TriEverthing/SC8815_Portable_Power/README.md

# SC8815 Portable Power

升降压可调电源，输入电压支持2.7\~36V，输出电压0.8V\~36V可调，最大输出电流5A，支持PD和DC输入
