TriEverthing/SC8815_Portable_Power/Hardware/Schmeatic/SC8815_Portable_Power_1v0.pdf

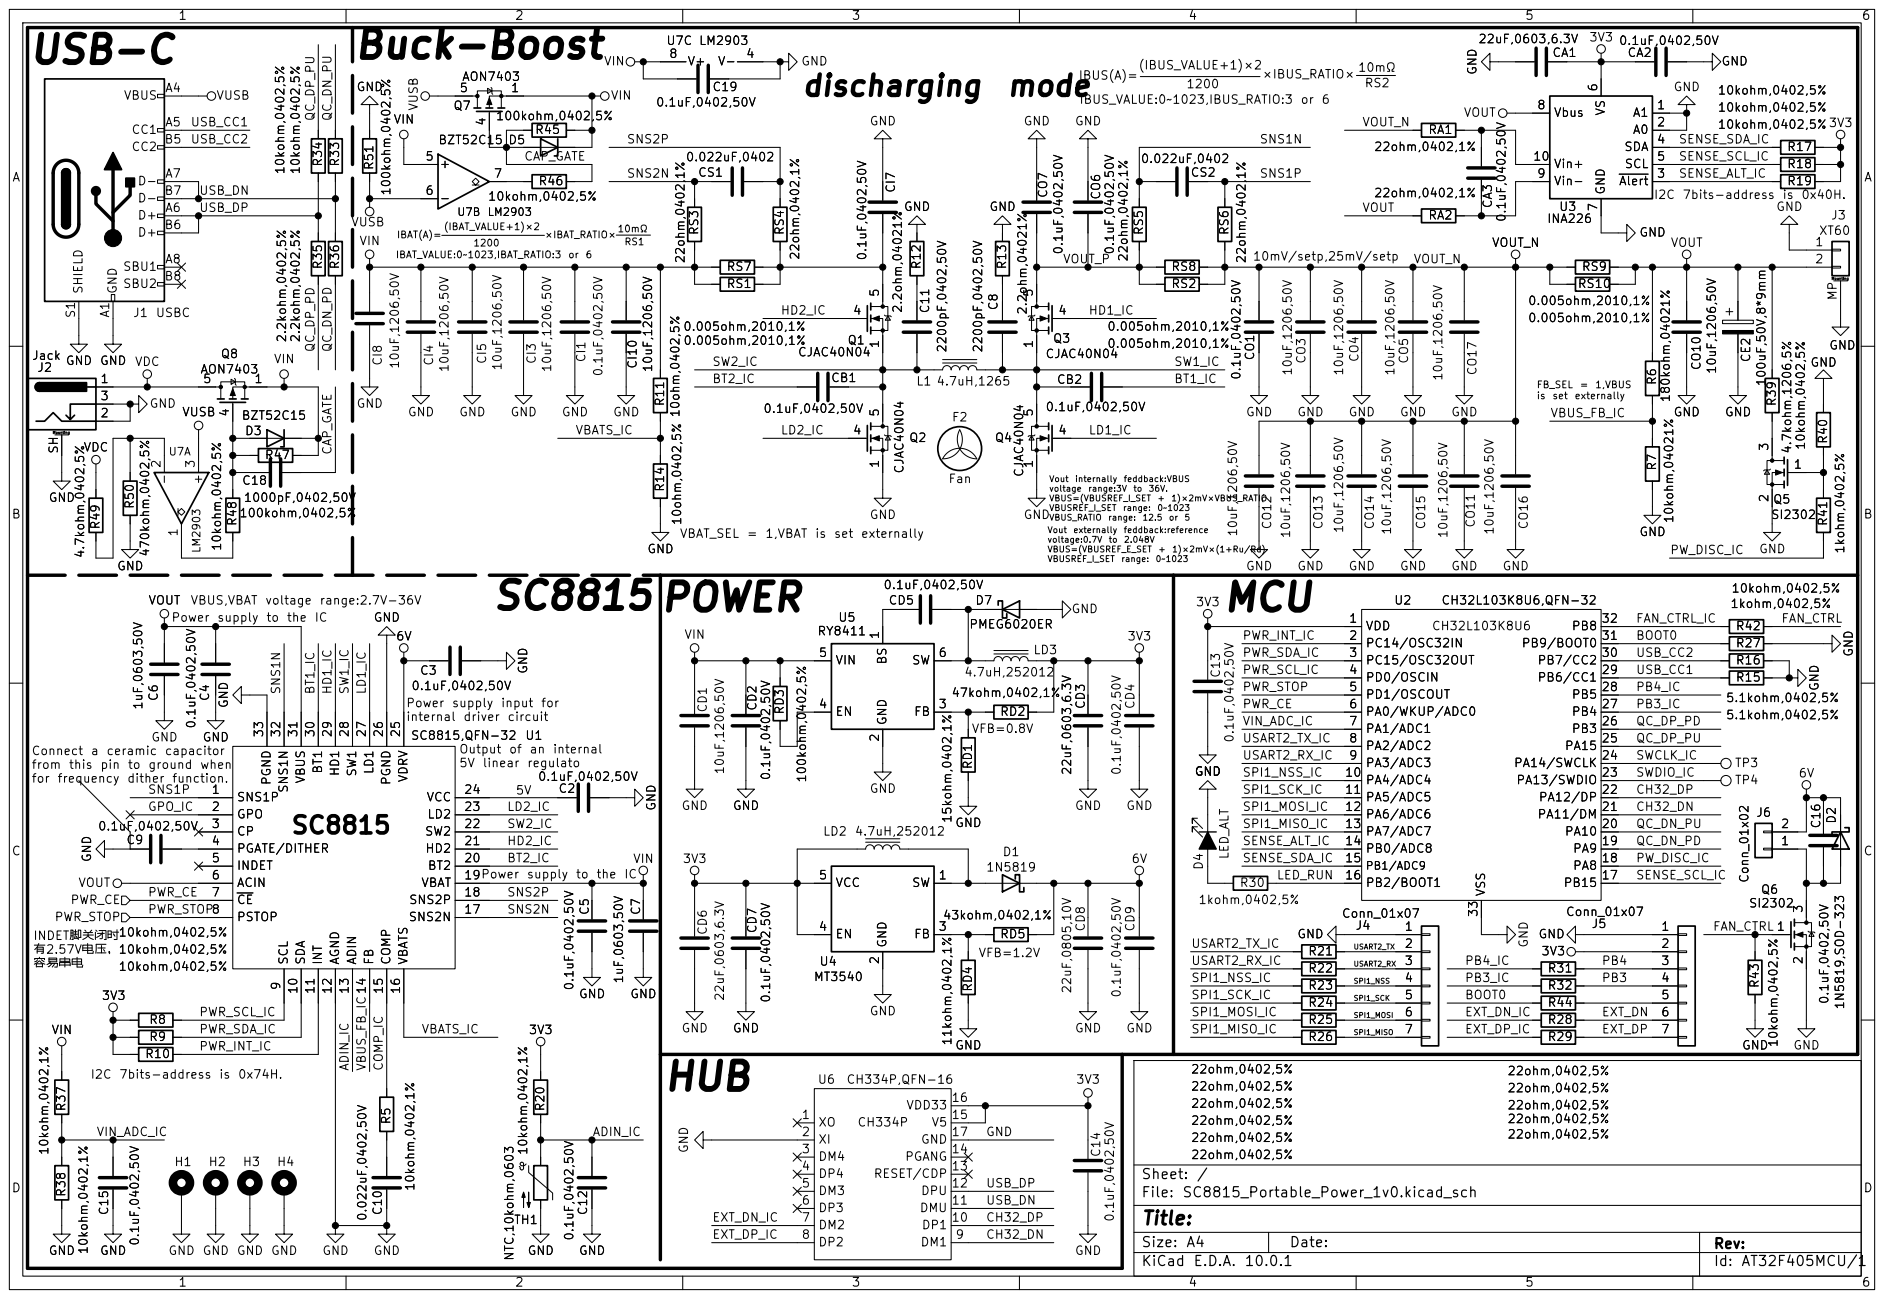
[picture p1: page 1]

10mV/setp,25mV/setp 1200 Buck-Boost

5 Q1 CJAC40N04 GND GND CO12 10uF,1206,50V CO13 10uF,1206,50V GNDCO1 0.1uF,0402,50V GNDCO3 10uF,1206,50V GND CO17 10uF,1206,50V GND CO4 10uF,1206,50V GND 10uF,1206,50V CO14 GND

Vout internally feddback:VBUS
voltage range:3V to 36V. VBUS=(VBUSREF_I_SET + 1)×2mV×VBUS_RATIO
GND
VBUS_RATIO range: 12.5 or 5
Vout externally feddback:reference
voltage:0.7V to 2.048V
VBUS=(VBUSREF_E_SET + 1)×2mV×(1+Ru/Rd) VBUSREF_I_SET range: 0~1023

VBAT_SEL = 1,VBAT is set externally

internal driver circuit Output of an internal 5V linear regulato 5V Power supply to the IC

from this pin to ground when

Size: A4 | Rev:
KiCad E.D.A. 10.0.1
