TriEverthing/SC8815_Portable_Power/Hardware/Schmeatic/Top_Portable_Power_2v0.pdf

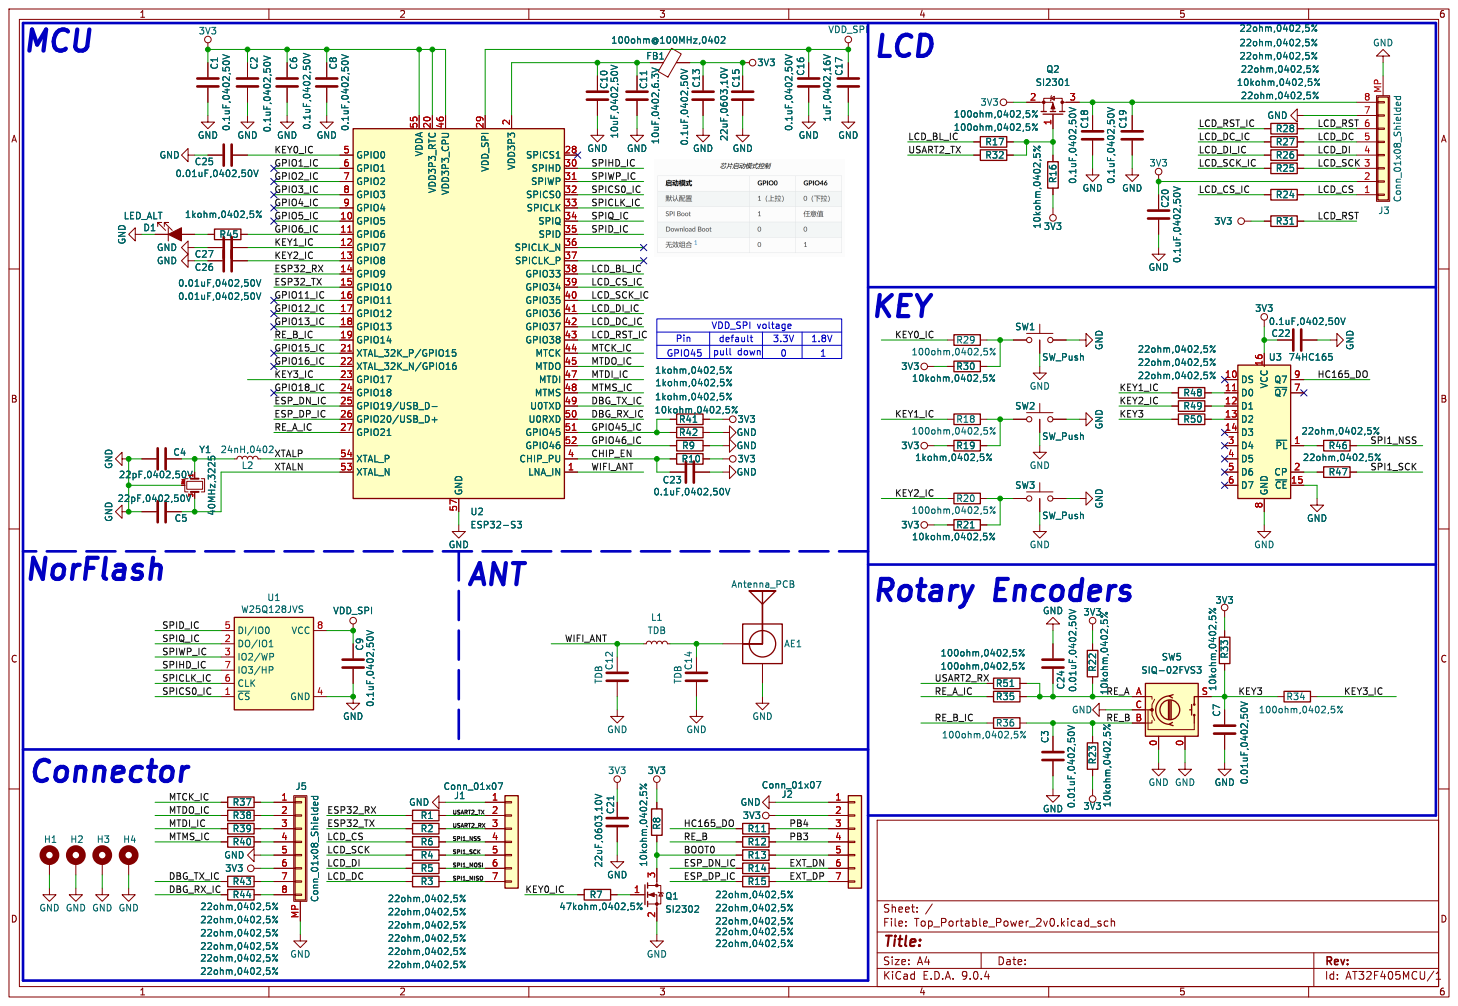
[picture p2: page 1]

2 SPICS1 28 SPIHD 30 SPIWP 31 SPICS0 32 SPICLK 33 SPIQ 34 SPID 35 SPICLK_P 37 GPIO33 38 GPIO34 39 GPIO35 40 GPIO36 41 GPIO37 42 GPIO38 43 MTCK 44 MTDI 47 MTMS 48 U0TXD 49 U0RXD 50 GPIO46 52 CHIP_PU 4

VCC 8 GND 4 DI/IO0 5 DO/IO1 2

Id: AT32F405MCU/1 Title: File: Top_Portable_Power_2v0.kicad_sch Sheet: /
