TriEverthing/SC8815_Portable_Power/Software/EmbedSoftware/CH32L103_Power_1v1/Hardware/inc/mcu_flash.h

#ifndef __MCU_FLASH_H
#define __MCU_FLASH_H

#include "stdio.h"
#include "stdint.h"

void mcu_flash_write(uint8_t *data , uint16_t len);
void mcu_flash_read(uint8_t *data , uint16_t len);
void mcu_flash_erase(void);

#endif
