TriEverthing/SC8815_Portable_Power/(commit log)

2026-07-02 init: SC8815便携电源项目初始提交
    [partitions.csv]
2026-07-02 feat: 新增LVGL为Git子模块，绑定v9.0稳定版
2026-07-02 Add Top_Power production files
    [bom.csv, designators.csv, positions.csv]
2026-07-02 Add Bottom_Power production files
    [bom.csv, designators.csv, positions.csv]
2026-07-02 Add boardview files
    [SC8815_Portable_Power_1v0.brd, Top_Portable_Power_2v0.brd]
2026-07-07 Modified st7735s.c driver files
2026-07-07 Modified knob driver
